AnujShah06/entropy-chess/chess_PCB/chess_card_pcb_context.md.pdf

A slightly oversized business card PCB (95 × 60 mm) that runs a dual-encoder energy-based chess AI on an ESP32-S3. The human plays one side; the card plays the other. Charges via USB-C or trickle-charges from a small back-mounted solar cell. No wireless connectivity required during play.

Designed for JLCPCB fabrication with PCBA assembly service.

Outline dimensions | 95 × 60 mm
Corner radius | 2 mm rounded
PCB thickness | 0.8 mm
Layers | 2 (top + bottom), standard FR4
Soldermask | Black
Silkscreen | White, both sides
Surface finish | ENIG (gold) — premium look, good for exposed touch pads
Special feature | 0.4 mm depth-controlled milling pocket on back (LiPo recess)
Assembly | JLCPCB PCBA for all SMD components

LiPo battery wires (to SMD JST-PH connector), coin haptic motor (2 wires), solar cell (2 wires), e-paper panel (FPC, no soldering — slides into latching connector). No through-hole soldering required.

- left-aligned, top-aligned, ~70 × 38 mm active area
- right side, vertically centered (3 pads in a column)
- right edge, bottom right corner
- bottom strip of front face, white text on black soldermask
- Text height: ~1.2 mm, clean sans-serif
- Centered horizontally across full card width
- Small chess piece silhouette or board corner motif

┌──────────────────────────────────────────────────────────────┐
│ ┌──────────────────────────────────────────┐ | [ ▲ UP | ] │
│ │ | │ | │
│ │ | 2.9" E-Paper Display | │ | [ ● SEL ] │
│ │ | (296 × 152px, 4-grayscale) | │ | │
│ │ | │ | [ ▼ DN | ] │
│ │ | │ | │
│ └──────────────────────────────────────────┘ | [ USB-C ] │
│ | │
│ | Neelay Ranjan | 773-668-0069 | rneelay@gmail.com | │
└──────────────────────────────────────────────────────────────┘

┌──────────────────────────────────────────────────────────────┐
│ | | | │
│ | [ESP32-S3-WROOM-2 Module] | [Solar Cell, 40×30mm] | │
│ | (antenna toward top edge) | | │
│ | | | │
│ | [BQ25570] [MCP73832] [XC6220] [MAX17048] [Motor pads] | │
│ | | | │
│ | [500mAh LiPo — sits in 0.4mm recess] | │
│ | | | │
│ | [● ● ● ● ●] ← 5 charge level LEDs | │
│ | | | │
│ | [RST bridge pads] | [Reset/restart pads] | │
│ | | | │
└──────────────────────────────────────────────────────────────┘

- upper center, antenna oriented toward top edge
- upper right, flush adhesive mount on back
- middle horizontal strip
- lower middle, sits in milled pocket, JST-PH SMD connector
- below LiPo, visible row of 0402 LEDs
- lower edge, 2 small exposed copper pads to short for hard reset
Part | ESP32-S3-WROOM-2-N16R8
Specs | Dual-core Xtensa LX7 @ 240MHz, 8MB PSRAM, 16MB Flash
Package | Castellated module, 18 × 25 × 3.1 mm
Placement | Back of card, upper center
Antenna orientation | Pointed toward top edge of card
LCSC search | "ESP32-S3-WROOM-2-N16R8"
- at top edge of module — no copper pours, traces, or vias whatsoever in this zone
- 100nF + 10µF ceramic caps on every VDD pin, placed within 0.5 mm
- 100µF on 3.3V rail near module VDD pins (handles inference current spikes)

Recommended part | GoodDisplay GDEY029F51
Size | 2.9" diagonal
Resolution | 296 × 152 pixels
Grayscale | 4 levels (white, light gray, dark gray, black)
Active area | ~67 × 35 mm
Refresh modes | Full refresh (~2s, 4-grayscale, flashy) + fast refresh (~300ms, B/W, no flash)
Idle power | ~0 µA (bistable — holds image with no power)
Voltage | 3.3V VCI
Connector | 24-pin FPC, 0.5 mm pitch, top-contact (verify against datasheet)
Placement | Front of card, flush to top-left corner
- | Use | for all in-game updates (cursor movement, AI move display, captured
| pieces)
- | Run | to clear ghosting
| | The internal charge pump needs ~5 dedicated 1µF ceramic caps on
VPOS, VNEG, VCOM, VGH/VSH, VGL/VSL pins.

Three buttons in a vertical column on the right side of the front face. Uses ESP32-S3 built-in capacitive touch — no external IC needed.

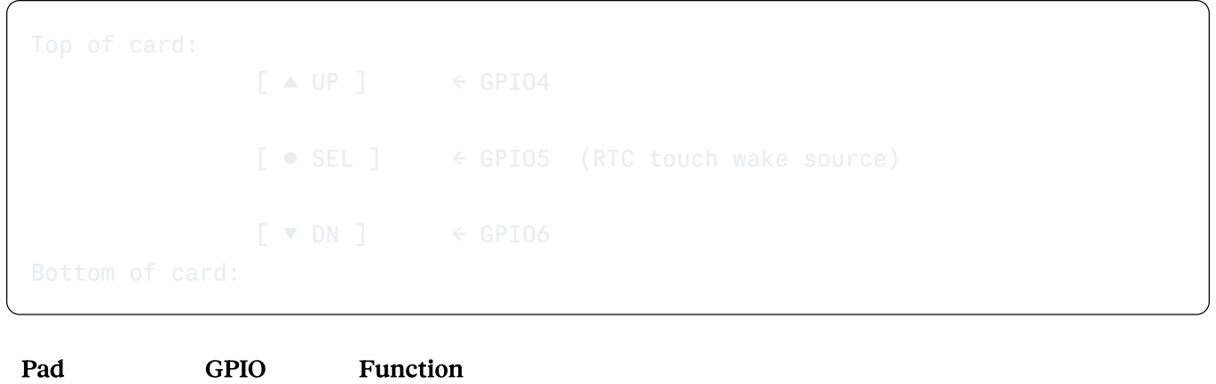
[picture p1: figure]
Top of card:; ← GPIO4; ← GPIO6; Bottom of card:

UP | GPIO4 | Cycle move list up
SELECT | GPIO5 | Confirm move / pick-and-place / wake from sleep
DOWN | GPIO6 | Cycle move list down
- Diameter: 8 mm exposed copper circles, front layer
- Pitch: 14 mm vertical spacing
- Surface finish: ENIG over pads (clean, finger-friendly)
- Soldermask: removed over pad area
- Silkscreen labels (▲, ●, ▼) on white silkscreen adjacent to each pad
- (kills capacitive sensitivity)
- Hatched ground only (not solid) within 10 mm of pads if ground reference needed
- Route touch traces on front layer only, short as possible, away from SPI traces and motor wires
- All three trace lengths roughly matched (within 5 mm of each other) for consistent sensitivity
- | Only the | is monitored by the RTC touch peripheral during deep
| sleep
- Touch wake adds ~10 µA to deep sleep current
- Firmware should dynamically calibrate touch threshold on each wake (read baseline for 50 ms, set threshold relative to baseline) to compensate for temperature/humidity drift
- Wake event must persist for 100 ms before counting (noise rejection)

[ ● SEL ] ← GPIO5 (RTC touch wake source)

Motor | NFP-C0820B or Jinlong C0820B02F (8 mm × 2.0 mm coin)
Drive transistor | 2N7002 N-channel MOSFET (SOT-23)
Flyback protection | 1N4148W diode across motor terminals (cathode to + terminal)
Gate driver pin | GPIO13
Power | LiPo+ direct (NOT 3.3V rail — avoids rail dipping during inference)
Mounting | Adhered to back of card with double-sided tape, post-assembly
PCB interface | Two solder pads for motor lead wires

Motor draws 60–80 mA spikes. Driving from LiPo+ instead of 3.3V prevents brown-outs of e-paper SPI and touch pads during haptic events.

USB-C connector | 16-pin SMD (LCSC: "USB-C 16pin SMD")
CC1/CC2 | 5.1kΩ pull-down resistors to GND (signals USB device, enables 5V)
ESD protection | USBLC6-2SC6 on D+/D- lines
D+ → ESP32-S3 | GPIO20
D- → ESP32-S3 | GPIO19
VBUS → | MCP73832 input (via Schottky diode)

Native USB-CDC over the S3's hardware USB peripheral. No CH340/CP2102 bridge IC needed. Flash via idf.py flash over USB-C.

Solar cell | 40 × 30 mm amorphous, 5V, ~30 mW peak
Mounting | Adhered to top of back face, flush, near top edge
Harvester IC | BQ25570 (TI, ultra-low-power)
Package | QFN-20
Quiescent current | 330 nA
Output | Charges LiPo directly, programmed for 4.2V max
External components | 22µH inductor, input/output caps, MPPT-setting resistors
LCSC search | "BQ25570RGRR"

BQ25570 VBAT_OK output → XC6220 EN pin (with small RC filter). When LiPo voltage drops below safe threshold, LDO disables and ESP32 powers off cleanly. Prevents brown-out corruption of RTC memory and flash.

Charger IC | MCP73832T-2ACI/OT
Package | SOT-23-5
Charge current | 500 mA (fast charge)
PROG resistor | 2.0 kΩ (sets 500 mA)
Input source | USB-C VBUS (BQ25570 charges LiPo independently from solar side)
Status output | STAT pin → ESP32 (via voltage divider, optional)
LCSC search | "MCP73832"

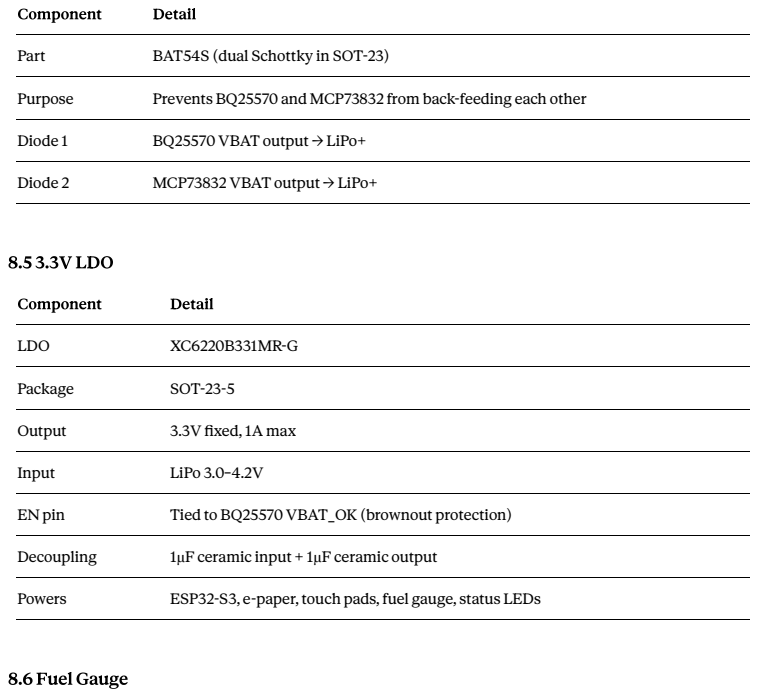
[picture p2: page 8]
Part; BAT54S (dual Schottky in SOT-23); Purpose; Prevents BQ25570 and MCP73832 from back-feeding each other; Diode 1; BQ25570 VBAT output → LiPo+; Diode 2; MCP73832 VBAT output → LiPo+; LDO; Package; SOT-23-5; Output; 3.3V fixed, 1A max; Input; LiPo 3.0–4.2V; EN pin; Tied to BQ25570 VBAT_OK (brownout protection); Decoupling; 1µF ceramic input + 1µF ceramic output; Powers; ESP32-S3, e-paper, touch pads, fuel gauge, status LEDs

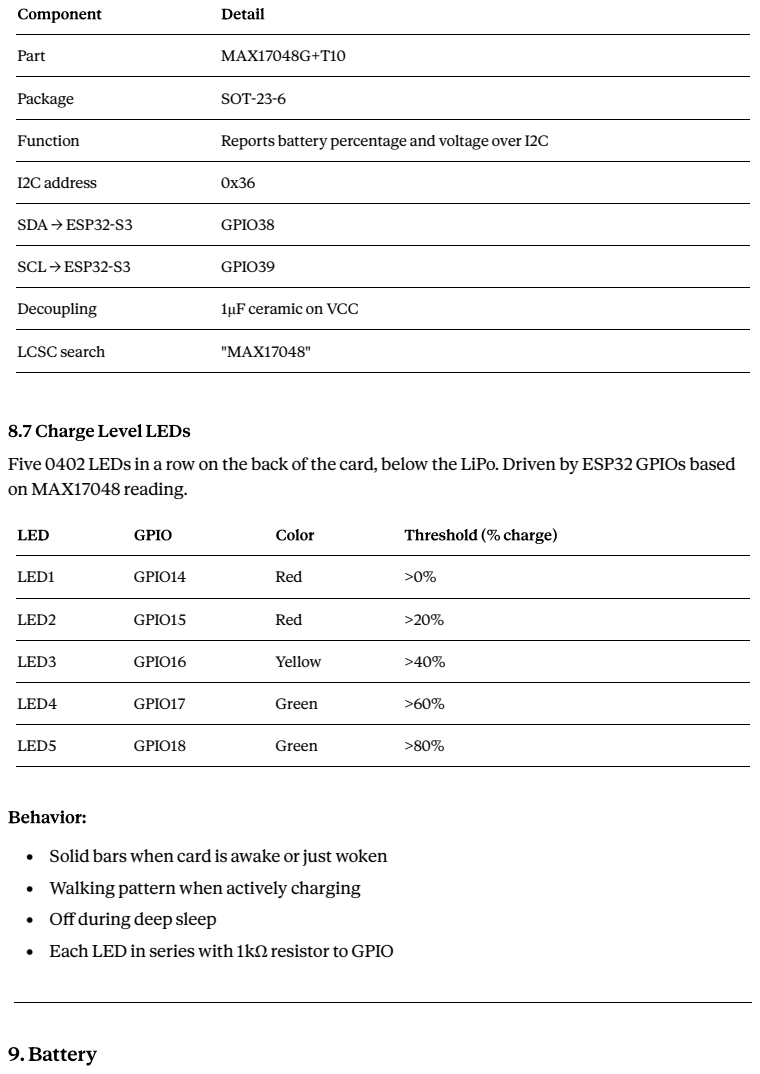
[picture p3: page 9]
Part; MAX17048G+T10; Package; SOT-23-6; Function; Reports battery percentage and voltage over I2C; I2C address; SDA → ESP32-S3; GPIO38; SCL → ESP32-S3; GPIO39; Decoupling; 1µF ceramic on VCC; LCSC search; "MAX17048"; LED1; GPIO14; Red; LED2; GPIO15; LED3; GPIO16; Yellow; LED4; GPIO17; Green; LED5; GPIO18

Five 0402 LEDs in a row on the back of the card, below the LiPo. Driven by ESP32 GPIOs based
on MAX17048 reading.

• Solid bars when card is awake or just woken
• Walking pattern when actively charging
• Off during deep sleep
• Each LED in series with 1kΩ resistor to GPIO

Recommended cell | EEMB LP503035
Capacity | 500 mAh
Dimensions | 35 × 30 × 5 mm
Voltage | 3.7V nominal, 4.2V max
Protection | Built-in PCM (overcharge / overdischarge / short circuit)
Connector | JST-PH 2.0 mm 2-pin SMD (S2B-PH-SM4-TB), JLCPCB-placeable
Mounting | Sits in 0.4 mm milled pocket on back of card

0.4 mm (remaining PCB) + 5 mm (LiPo) = 5.4 mm. This is the thickest point on the card. ESP32-S3 module elsewhere is 0.8 + 3.1 = 3.9 mm.

In place of a tactile reset button. Two small exposed copper pads on the back of the card, near bottom edge.

Pad size | 1.5 × 1.5 mm each
Pad spacing | 1.5 mm apart
Function | Bridging pads shorts EN to GND, hard-resets ESP32
Silkscreen label | "RST"
Field finish | Cover with hot glue or Kapton tape after firmware loading and validation

— card is always in deep sleep when not in use, woken by SELECT touch. The reset bridge pads are for emergency use during development and rare in-field resets.

USB-C VBUS ─────[BAT54S]───┐
├──> MCP73832 VDD_IN ──> LiPo (+)
Solar Cell ──> BQ25570 ────┘ | │
│ | │
└──> VBAT_OK ──> XC6220 EN | │
| │
LiPo (+) ──> XC6220 IN ──> 3.3V rail | │
LiPo (-) ──> GND | │
LiPo (+) ──> MAX17048 (battery monitor I2C) | │
LiPo (+) ──> 2N7002 source ──> ERM motor return | │

XC6220 OUT ──> 3.3V rail ──> ESP32-S3 (3V3)
──> E-paper VCC
──> Touch pads (via GPIO)
──> MAX17048 VCC
──> Charge LEDs (via GPIO)

Solar tab (+) ──> BQ25570 VIN_DC Solar tab (-) ──> GND

USB-C CC1 ──> 5.1kΩ ──> GND
USB-C CC2 ──> 5.1kΩ ──> GND
USB-C D+ ──> USBLC6 ──> ESP32-S3 GPIO20 USB-C D- ──> USBLC6 ──> ESP32-S3 GPIO19

ESP32-S3 GPIO11 ──> E-paper MOSI ESP32-S3 GPIO12 ──> E-paper SCK ESP32-S3 GPIO10 ──> E-paper CS ESP32-S3 GPIO9 ──> E-paper DC ESP32-S3 GPIO8 ──> E-paper RST ESP32-S3 GPIO7 ──> E-paper BUSY

ESP32-S3 GPIO4 ──> Touch UP
ESP32-S3 GPIO5 ──> Touch SELECT (RTC wake source) ESP32-S3 GPIO6 ──> Touch DOWN

ESP32-S3 GPIO13 ──> 2N7002 GATE ──> ERM motor
1N4148W ──> across ERM motor terminals (flyback)

ESP32-S3 GPIO14–18 ──> 5 charge level LEDs (via 1kΩ each)

ESP32-S3 GPIO38 ──> I2C SDA (MAX17048)
ESP32-S3 GPIO39 ──> I2C SCL (MAX17048)

ESP32-S3 EN ──> BQ25570 VBAT_OK (brownout protection) ESP32-S3 EN ──> RST bridge pads ──> GND (manual reset)

ESP32-S3 EN ──> RST bridge pads ──> GND (manual reset)
ESP32-S3 EN ──> 10kΩ pull-up to 3.3V

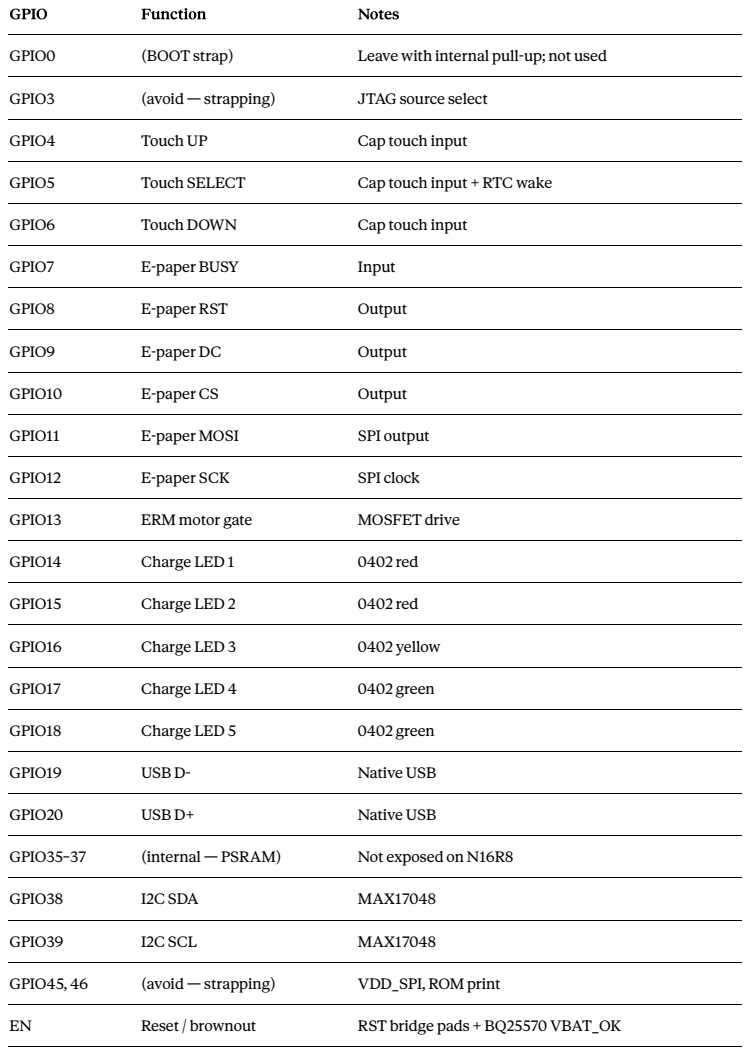
[picture p4: page 13]
GPIO0; (BOOT strap); Leave with internal pull-up; not used; GPIO3; (avoid — strapping); JTAG source select; GPIO4; Touch UP; Cap touch input; GPIO5; Touch SELECT; Cap touch input + RTC wake; GPIO6; Touch DOWN; GPIO7; E-paper BUSY; Input; GPIO8; E-paper RST; Output; GPIO9; E-paper DC; GPIO10; E-paper CS; GPIO11; E-paper MOSI; SPI output; GPIO12; E-paper SCK; SPI clock; GPIO13; ERM motor gate; MOSFET drive; GPIO14; Charge LED 1; 0402 red; GPIO15; Charge LED 2; GPIO16; Charge LED 3; 0402 yellow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

Board on the left, status/controls on the right (closest to the button column for shortest reach). User's hand operating the right-edge buttons doesn't block the board.

- 8×8 chess board with 16×16 px squares, piece sprites in 4 grayscale levels
- Shows pieces taken by each side, plus last move in algebraic notation
- "Thinking..." progress bar during AI inference, AI's chosen move, scrollable list of legal moves for human player, current selection indicator

shown briefly on wake via the 5 back-side LEDs. E-paper does not display battery during gameplay (saves screen real estate).

- Card in deep sleep by default
- Touch SELECT pad → RTC touch wakes ESP32 → boots in ~200 ms

┌─────────────────────────────────────────────┐ │ ┌─────────┐ ┌──────────┐ ┌────────────────┐ │
│ │ | │ │ Captured │ │ Thinking... | │ │
│ │ 8x8 | │ │ ♟♟♟♞ | │ │ ▓▓▓▓░░░░░ 60% │ │
│ │ board │ │ | │ │ | │ │
│ │ | │ │ ♙♙♘♗ | │ │ AI move: Nf3 | │ │
│ │ 128×128 │ │ | │ │ | │ │
│ │ | │ │ Last: | │ │ Your moves: | │ │
│ │ | │ │ ...e5 | │ │ ▶ e5 | │ │
│ │ | │ │ | │ │ | d6 | │ │
│ │ | │ │ | │ │ | c5 | │ │
│ │ | │ │ | │ │ [▲▼ scroll] | │ │
│ │ | │ │ | │ │ [● confirm] | │ │
│ └─────────┘ └──────────┘ └────────────────┘ │
│ ~128 px | ~70 px | ~98 px | │
└─────────────────────────────────────────────┘
board | middle | right

- E-paper displays: "Difficulty: ▶ Beginner / Intermediate / Expert"
- UP/DOWN scroll between options
- SELECT confirms, starts game
- "Thinking..." progress bar fills as inference runs (target: ≤10s per move)
- Haptic buzz when move is chosen
- AI's move shown in algebraic notation, board updates with arrow indicator
- Card transitions to user's turn
- List of legal moves displayed, ranked byAI's evaluation
- UP/DOWN scroll the list, current selection shown with ▶ marker and on-board highlight
- SELECT confirms the chosen move, board updates
- Hold UP + DOWN simultaneously for 3 seconds → restart confirmation prompt
- SELECT confirms restart, returns to difficulty selection
- When no game is in progress, card sleeps
- E-paper displays: name, contact info, dynamic QR code (encodes vCard or portfolio URL)
- Refresh once on long-interval wake (every few days) to prevent ghosting
- Touch SELECT to enter game mode

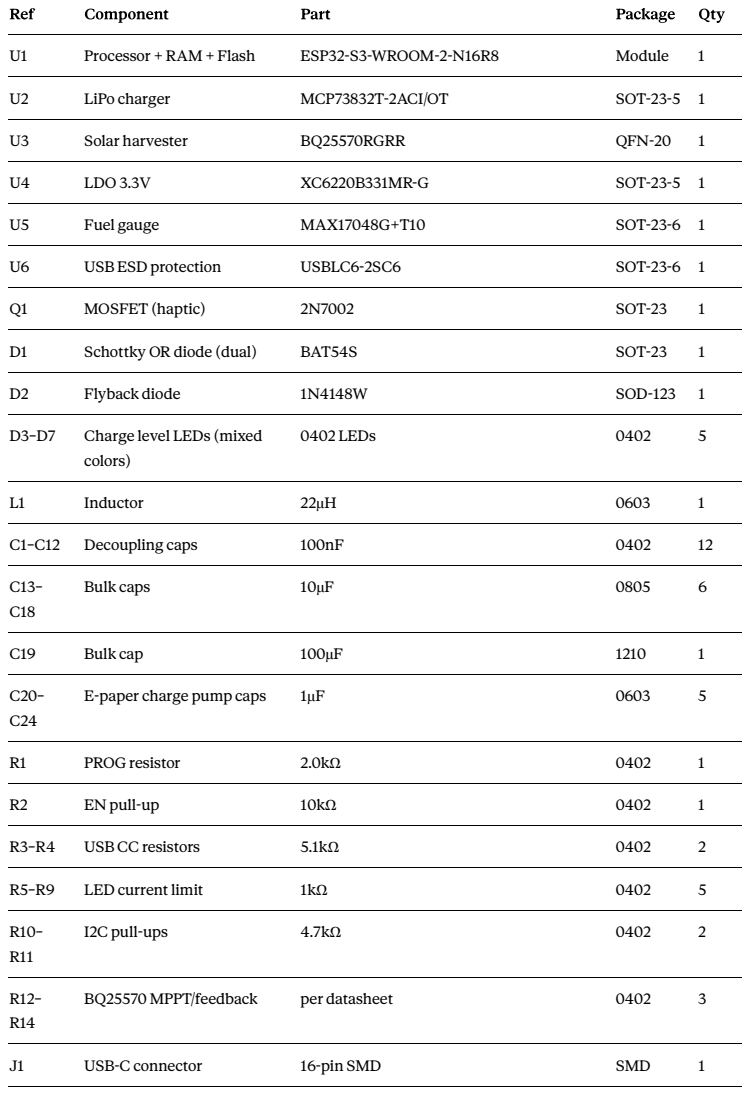
[picture p5: page 16]

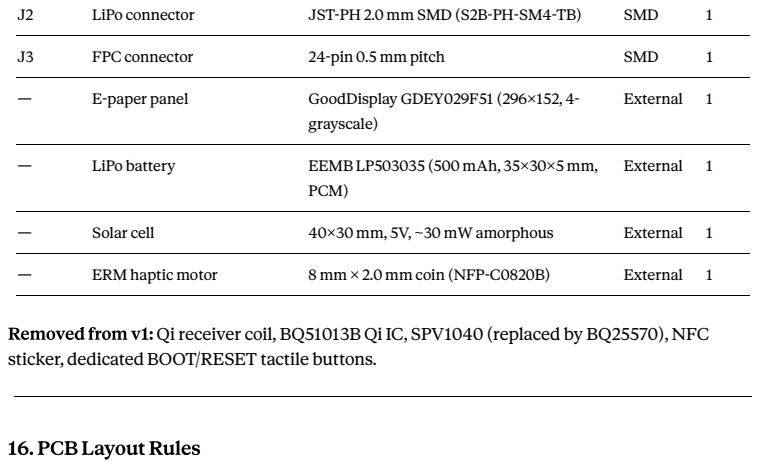
[picture p6: page 17]
LiPo connector; JST-PH 2.0 mm SMD (S2B-PH-SM4-TB); SMD; FPC connector; 24-pin 0.5 mm pitch; E-paper panel; GoodDisplay GDEY029F51 (296×152, 4-; grayscale); External; LiPo battery; EEMB LP503035 (500 mAh, 35×30×5 mm,; PCM); Solar cell; 40×30 mm, 5V, ~30 mW amorphous; ERM haptic motor; 8 mm × 2.0 mm coin (NFP-C0820B)

Qi receiver coil, BQ51013B Qi IC, SPV1040 (replaced by BQ25570), NFC

sticker, dedicated BOOT/RESET tactile buttons.

. | at antenna end — no copper, traces, or vias whatsoever, both layers
. | — destroys capacitive sensitivity. Hatched ground only within 10 mm if needed
. | front copper layer only, as short as possible, lengths matched within 5 mm, route away from SPI traces and motor wires
. | within 0.5 mm of every VDD/GND pin pair on ESP32-S3
module
. | solid pour on both layers (except keepout zones), via stitch every 5 mm around board perimeter
. | short, matched length, away from power traces and haptic motor
wires
. | keep ground pour but no signal traces under cell adhesive footprint — avoid voltage offsets from light-induced photocurrent in traces
. | keep away from touch pad traces — motor switching injects noise. Drive from LiPo+ rail, not 3.3V rail
. | — replaced by dynamic e-paper QR
. | route as 90Ω differential pair, length matched, place USBLC6 within 5 mm of connector
. | close to LiPo+ sense point, short trace
. | row of 5 LEDs in a clear row on back, below LiPo, visible when card is held back-up
. | lower edge of back, away from high-current charging traces and ESP32- S3 module heat
. | 0.4 mm deep, sized to LiPo footprint + 0.5 mm clearance, on back side, marked clearly in fab drawing

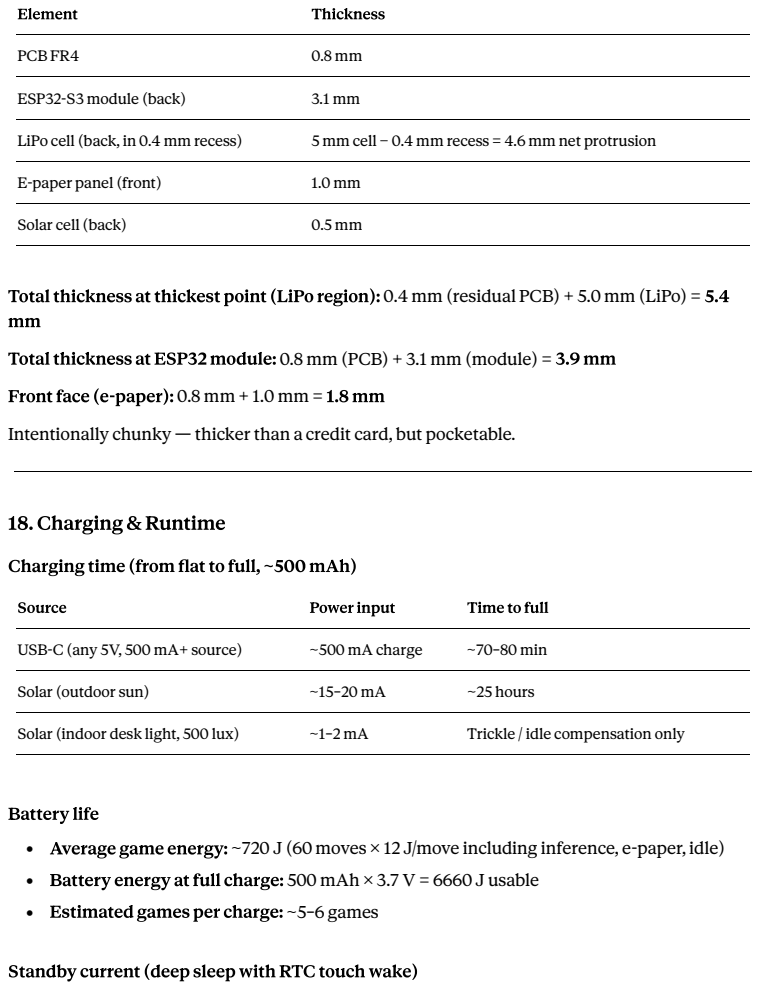
[picture p7: page 19]
PCB FR4; ESP32-S3 module (back); LiPo cell (back, in 0.4 mm recess); 5 mm cell − 0.4 mm recess = 4.6 mm net protrusion; E-paper panel (front); Solar cell (back); USB-C (any 5V, 500 mA+ source); ~500 mA charge; ~70–80 min; Solar (outdoor sun); ~25 hours; Solar (indoor desk light, 500 lux); Trickle / idle compensation only

0.4 mm (residual PCB) + 5.0 mm (LiPo) =

0.8 mm (PCB) + 3.1 mm (module) =

Intentionally chunky — thicker than a credit card, but pocketable.

• ~720 J (60 moves × 12 J/move including inference, e-paper, idle)
• 500 mAh × 3.7 V = 6660 J usable
• ~5–6 games

- ESP32-S3 deep sleep: ~10 µA
- XC6220 LDO quiescent: ~8 µA
- BQ25570 quiescent: ~0.3 µA
- MAX17048 quiescent: ~3 µA
- LiPo PCM: ~3 µA
- | µ | µ
- Indoor desk light harvest: ~1–2 mW (after BQ25570 efficiency)
- Standby draw: ~0.09 mW
- — solar trickle keeps card topped up between games

. Order board as standard 2-layer PCB — no rigid-flex
. Specs: FR4, 0.8 mm, black soldermask, white silkscreen, ENIG finish, 2 mm corner radius
. Specify | on back side, sized for LiPo footprint
. Upload Gerbers + BOM + CPL for JLCPCB PCBA assembly
. Initial run: | (validate v1 before scaling)
. All SMD components assembled by JLCPCB PCBA, including USB-C, FPC connector, JST-PH SMD
. Post-assembly hand work:
- Solder LiPo wires to JST-PH (no SMD soldering — slip-fit connector)
- Adhere Qi coil
- Adhere solar cell to back, solder 2 wires to PCB pads
- Attach ERM motor with adhesive, solder 2 wires to PCB pads
- Slide e-paper FPC into J3 connector, close latch
- Cover RST bridge pads with hot glue or Kapton after first flash + validation

. First programming: USB-C with ESP-IDF, ESP32-S3 board package
. Partition scheme: bootloader + app + dedicated model partition (5–10 MB) + nvs + spiffs . Flash model file separately from firmware via parttool.py to avoid reflashing 10 MB on every code change

- Private
- schematic / PCB / firmware / model / docs subdirectories
- TBD (private project)

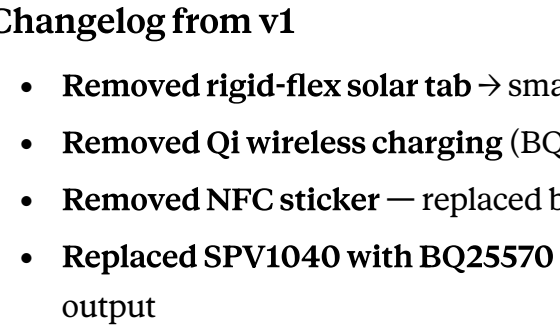
[picture p8: figure]
output

- → small flat solar cell on back of card
- (BQ51013B + 40×40 mm coil) — cost reduction
- — replaced by dynamic e-paper QR code in demo mode
- — proper ultra-low-power harvester with brownout
- — 500 mA fast charging instead of 150 mA
- GPIO19/20 (not GPIO43/44 — those are UART0)
- ESD protection on USB data lines
- 296×152 4-grayscale (GDEY029F51) instead of 296×128 B/W
- (UP / SELECT / DOWN, vertical column)
- for accurate battery percentage reporting
- on back, driven by ESP32 GPIOs
- → replaced by RST bridge pads (hot glue over after

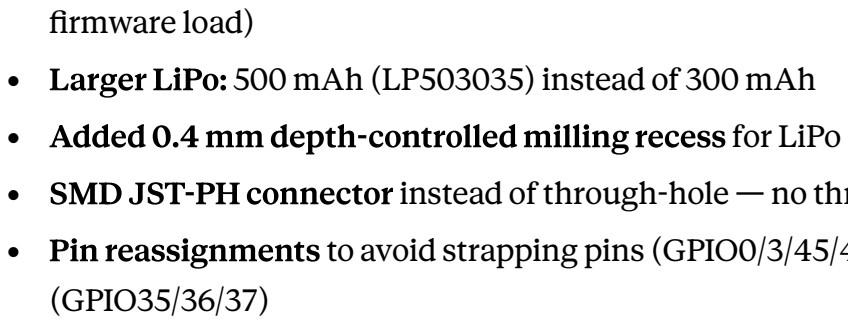
[picture p9: figure]
firmware load); • 500 mAh (LP503035) instead of 300 mAh; • for LiPo; (GPIO35/36/37)

- instead of through-hole — no through-hole soldering required
- to avoid strapping pins (GPIO0/3/45/46) and PSRAM-internal pins
- BQ25570 VBAT_OK → XC6220 EN
- rail (not 3.3V) to prevent rail dipping
