AnujShah06/entropy-chess/(list of files, drawings)

Other design files:
chess_PCB/freerouting.dsn
