AnujShah06/entropy-chess/chess_PCB/chess_PCB.kicad_pcb

## KiCad design chess_PCB/chess_PCB.kicad_pcb (2026-05-04)

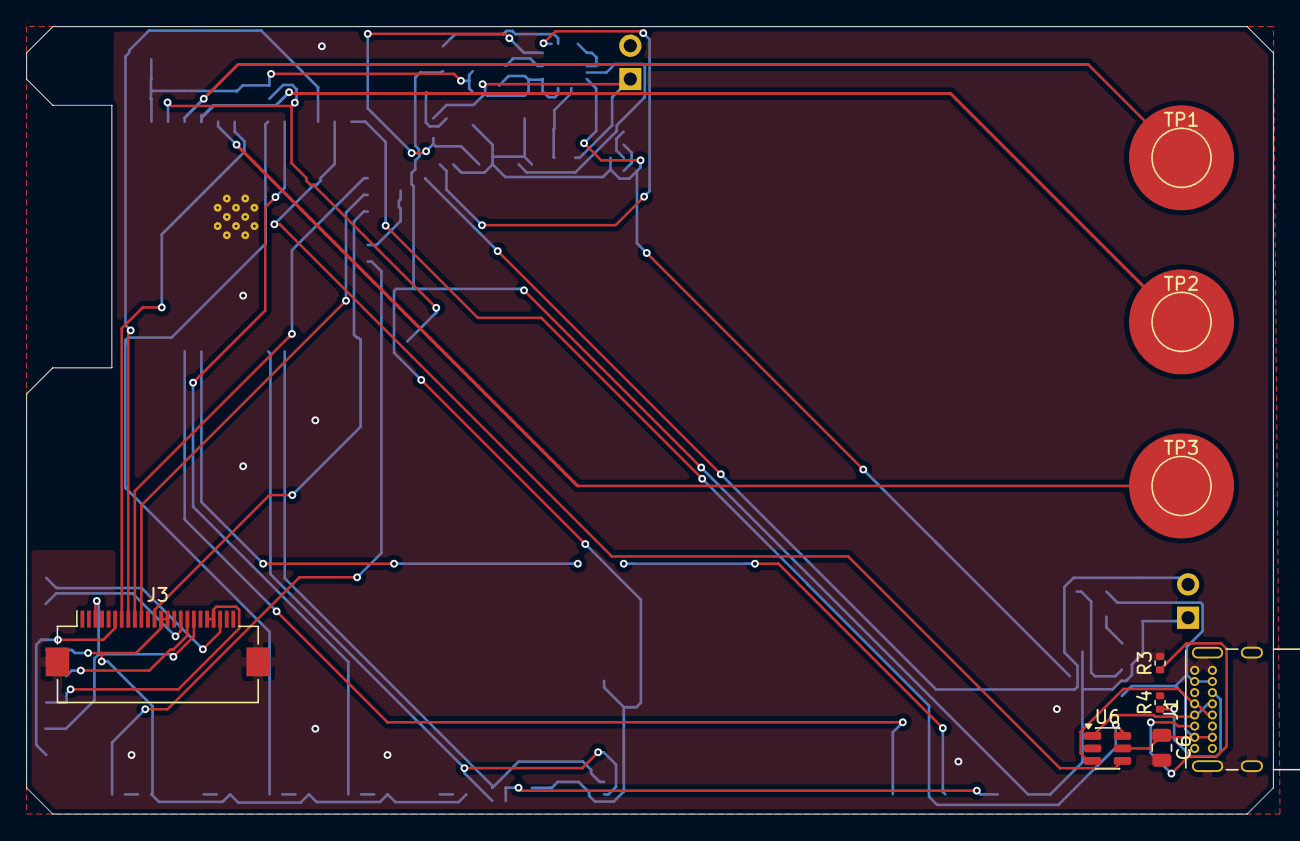
[picture p10: board chess_PCB.kicad_pcb from above]

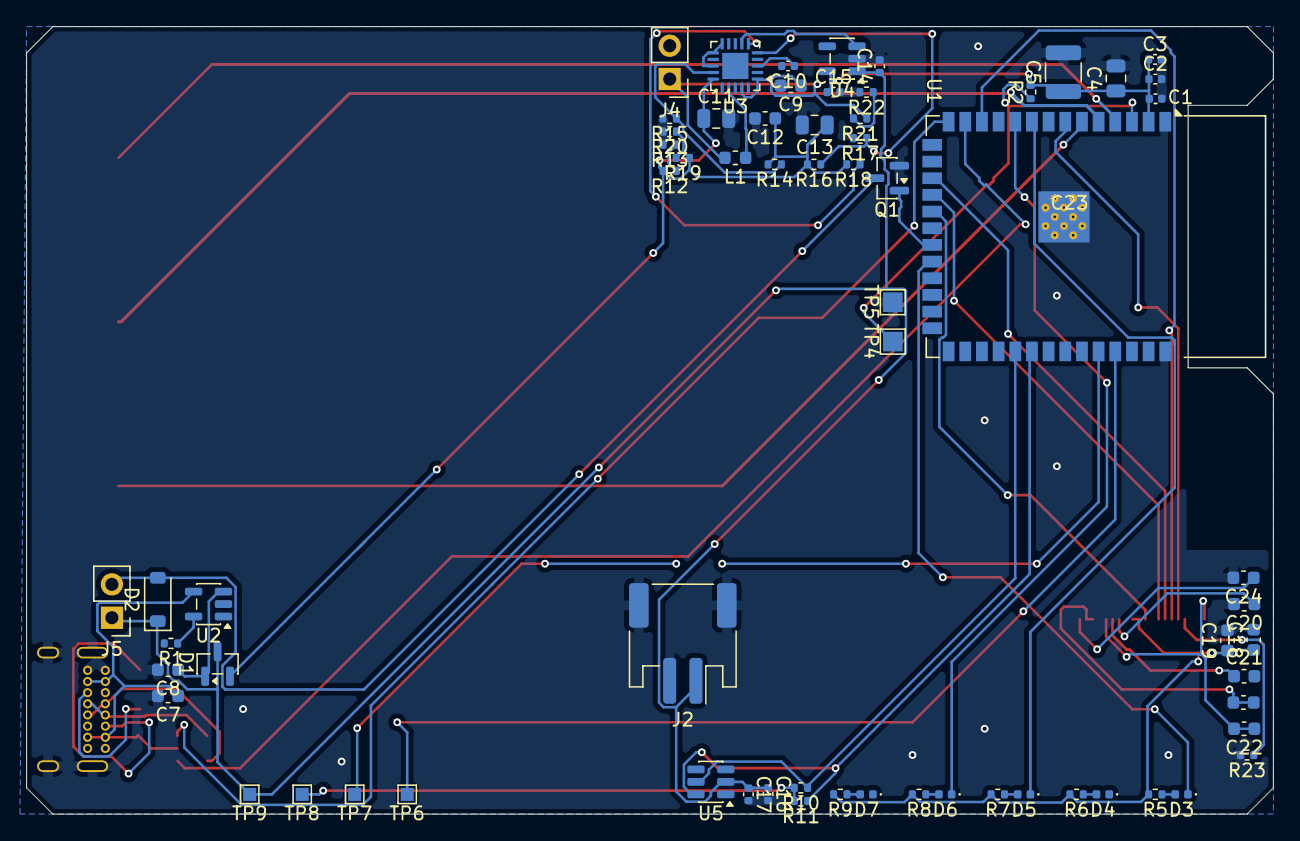
[picture p11: board chess_PCB.kicad_pcb from below]

Board: 2 copper layers, 95.0 x 60.0 mm, 76 parts (67 on the bottom side), 56 nets.

Parts:
C1, C2, C3, C17: 100nF; C_0402_1005Metric
C4, C6, C13: 10uF; C_0805_2012Metric
C5: 100uF; C_1210_3225Metric
C7, C8, C9, C12: 4.7uF; C_0603_1608Metric
C10: 10nF; C_0402_1005Metric
C11: 22uF; C_0805_2012Metric
C14, C15, C16: 1uF; C_0402_1005Metric
C18, C19, C20, C21, C22, C23, C24: 1uF; C_0603_1608Metric
D1: BAT54S; SOT-23
D2: 1N4148W; D_SOD-123
D3, D4: Red; LED_0402_1005Metric
D5: Yellow; LED_0402_1005Metric
D6, D7: Green; LED_0402_1005Metric
J1: USB-C 16P SMD; USB_C_Receptacle_GCT_USB4085
J2: JST-PH 2P SMD; JST_PH_S2B-PH-SM4-TB_1x02-1MP_P2.00mm_Horizontal
J3: FPC 24P 0.5mm; Hirose_FH12-24S-0.5SH_1x24-1MP_P0.50mm_Horizontal
J4: Solar Cell Pads; PinHeader_1x02_P2.54mm_Vertical
J5: ERM Motor Pads; PinHeader_1x02_P2.54mm_Vertical
L1: 22uH; L_0603_1608Metric
Q1: 2N7002; SOT-23
R1: 2k; R_0402_1005Metric
R2, R23: 10k; R_0402_1005Metric
R3, R4: 5.1k; R_0402_1005Metric
R5, R6, R7, R8, R9: 1k; R_0402_1005Metric
R10, R11: 4.7k; R_0402_1005Metric
R12: 5.49M; R_0402_1005Metric
R13: 3.39M; R_0402_1005Metric
R14: 5.65M; R_0402_1005Metric
R15: 4.42M; R_0402_1005Metric
R16: 5.07M; R_0402_1005Metric
R17: 3.69M; R_0402_1005Metric
R18: 6.04M; R_0402_1005Metric
R19: 7.50M; R_0402_1005Metric
R20: 3.32M; R_0402_1005Metric
R21, R22: 10M; R_0402_1005Metric
TP1: Touch UP; TestPoint_Pad_D4.0mm
TP2: Touch SELECT; TestPoint_Pad_D4.0mm
TP3: Touch DOWN; TestPoint_Pad_D4.0mm
TP4: RST_BRIDGE_A; TestPoint_Pad_1.5x1.5mm
TP5: RST_BRIDGE_B; TestPoint_Pad_1.5x1.5mm
TP6: TP_TX; TestPoint_Pad_1.0x1.0mm
TP7: TP_RX; TestPoint_Pad_1.0x1.0mm
TP8: TP_3V3; TestPoint_Pad_1.0x1.0mm
TP9: TP_VBAT; TestPoint_Pad_1.0x1.0mm
U1: ESP32-S3-WROOM-2-N16R8; ESP32-S3-WROOM-1
U2: MCP73832T-2ACI/OT; SOT-23-5
U3: BQ25570RGRR; QFN-20-1EP_3.5x3.5mm_P0.5mm_EP2x2mm
U4: XC6220B331MR-G; SOT-23-5
U5: MAX17048G+T10; SOT-23-6
U6: USBLC6-2SC6; SOT-23-6

Connections:
+3V3: C1.1, C2.1, C3.1, C4.1, C5.1, C15.1, C18.1, C19.1, J3.13 (VDDIO), J3.14 (VCI), R2.2, R5.2, R6.2, R7.2, R8.2, R9.2, R10.2, R11.2, TP8.1, U1.2 (3V3), U4.5 (VOUT)
BQ_LBOOST: L1.1, U3.17 (LBOOST)
BQ_OK_HYST: R18.1, U3.6 (OK_HYST)
BQ_OK_PROG: R16.1, R17.1, U3.5 (OK_PROG)
BQ_VBAT_OV: R12.1, R13.1, U3.12 (VBAT_OV)
BQ_VBAT_UV: R14.1, R15.1, U3.14 (VBAT_UV)
BQ_VOC_SAMP: R21.2, R22.1, U3.2 (VOC_SAMP)
BQ_VOUT_SET: R19.2, R20.1, U3.9 (VOUT_SET)
BQ_VRDIV: U3.4 (VRDIV), U3.16 (VRDIV2)
BQ_VREF_SAMP: C10.1, U3.3 (VREF_SAMP)
CC1: J1.A5 (CC1), R3.1
CC2: J1.B5 (CC2), R4.1
CHG_PROG: R1.1, U2.5 (PROG)
DEBUG_RX: TP7.1, U1.36 (RXD0)
DEBUG_TX: TP6.1, U1.37 (TXD0)
EP_BS: J3.6 (BS), R23.1
EP_BUSY: J3.7 (BUSY), U1.7 (IO7)
EP_CS: J3.10 (CS_N), U1.18 (IO10)
EP_DC: J3.9 (DC), U1.17 (IO9)
EP_MOSI: J3.12 (SDA), U1.19 (IO11)
EP_RST: J3.8 (RES_N), U1.12 (IO8)
EP_SCK: J3.11 (SCL), U1.20 (IO12)
EP_VCOM: C24.1, J3.22 (VCOM)
EP_VDD: C20.1, J3.16 (VDD)
EP_VGH_VGL: C23.1, C23.2, J3.20 (VGL), J3.21 (VGH)
EP_VPP: C21.1, J3.17 (VPP)
EP_VSH_VSL: C22.1, C22.2, J3.3 (VSH), J3.18 (VSL)
ESP_EN: R2.1, TP4.1, U1.3 (EN)
GND: C1.2, C2.2, C3.2, C4.2, C5.2, C6.2, C7.2, C8.2, C9.2, C10.2, C11.2, C12.2, C13.2, C14.2, C15.2, C16.2, C17.2, C18.2, C19.2, C20.2, C21.2, C24.2, J1.A1 (GND), J1.A12 (GND), J1.B1 (GND), J1.B12 (GND), J1.SH (SHIELD), J2.2 (GND), J2.MP, J3.4 (TSCL), J3.5 (TSDA), J3.15 (VSS), J3.24 (VSS2), J3.MP, J4.2 (SOL_MINUS), Q1.2 (S), R1.2, R3.2, R4.2, R13.2, R15.2, R17.2, R20.2, R22.2, R23.2, TP5.1, U1.1 (GND), U1.40 (GND), U1.41 (EPAD), U2.2 (GND), U3.18 (VSS), U3.20 (EN), U3.21 (EPAD), U4.2 (GND), U5.1 (QSTRT), U5.3 (GND), U6.2 (GND)
HAPTIC_GATE: Q1.1 (G), U1.21 (IO13)
I2C_SCL: R11.1, U1.32 (IO39), U5.6 (SCL)
I2C_SDA: R10.1, U1.31 (IO38), U5.5 (SDA)
LED1_NET: D3.1 (K), U1.22 (IO14)
LED1_R: D3.2 (A), R5.1
LED2_NET: D4.1 (K), U1.8 (IO15)
LED2_R: D4.2 (A), R6.1
LED3_NET: D5.1 (K), U1.9 (IO16)
LED3_R: D5.2 (A), R7.1
LED4_NET: D6.1 (K), U1.10 (IO17)
LED4_R: D6.2 (A), R8.1
LED5_NET: D7.1 (K), U1.11 (IO18)
LED5_R: D7.2 (A), R9.1
MOTOR_NEG: D2.2 (A), J5.2 (MOT_MINUS), Q1.3 (D)
SOL_CHG: C11.1, C12.1, C13.1, D1.2 (A2), R12.2, R14.2, R16.2, R18.2, R19.1, U3.10 (VOUT_EN), U3.11 (VOUT), U3.13 (VBAT), U3.15 (VSTOR)
TOUCH_DN: TP3.1, U1.6 (IO6)
TOUCH_SEL: TP2.1, U1.5 (IO5)
TOUCH_UP: TP1.1, U1.4 (IO4)
USB_CHG: C8.1, D1.1 (A1), U2.3 (VBAT)
USB_DM: J1.A7 (DN1), J1.B7 (DN2), U6.3 (IO2)
USB_DM_PROT: U1.13 (IO19), U6.4 (IO2_P)
USB_DP: J1.A6 (DP1), J1.B6 (DP2), U6.1 (IO1)
USB_DP_PROT: U1.14 (IO20), U6.6 (IO1_P)
VBAT: C14.1, C16.1, C17.1, D1.3 (K), D2.1 (K), J2.1 (VBAT), J5.1 (MOT_PLUS), TP9.1, U4.1 (VIN), U5.2 (VDD)
VBAT_OK: U3.7 (VBAT_OK), U4.3 (EN)
VBUS: C6.1, C7.1, J1.A4 (VBUS), J1.A9 (VBUS), J1.B4 (VBUS), J1.B9 (VBUS), U2.4 (VDD), U6.5 (VBUS)
VSOLAR: C9.1, J4.1 (SOL_PLUS), L1.2, R21.1, U3.1 (VIN_DC), U3.19 (VIN_DC)
