AnujShah06/entropy-chess/(commit log)

2026-05-01 removed vqvae, custom no-downsample encoder
2026-05-01 removed vqvae, added custom encoder
2026-05-01 Precompute dataset + fixed loader
    [dataset.py]
2026-05-01 training stage 1
2026-05-03 chess PCB
2026-05-03 updated pcb
2026-05-04 pcb placement
2026-05-04 final PCB
    [chess_PCB.kicad_pcb, chess_PCB.kicad_sch, freerouting.dsn]
